BekiryY/fire_core_nano/doc/hero.png

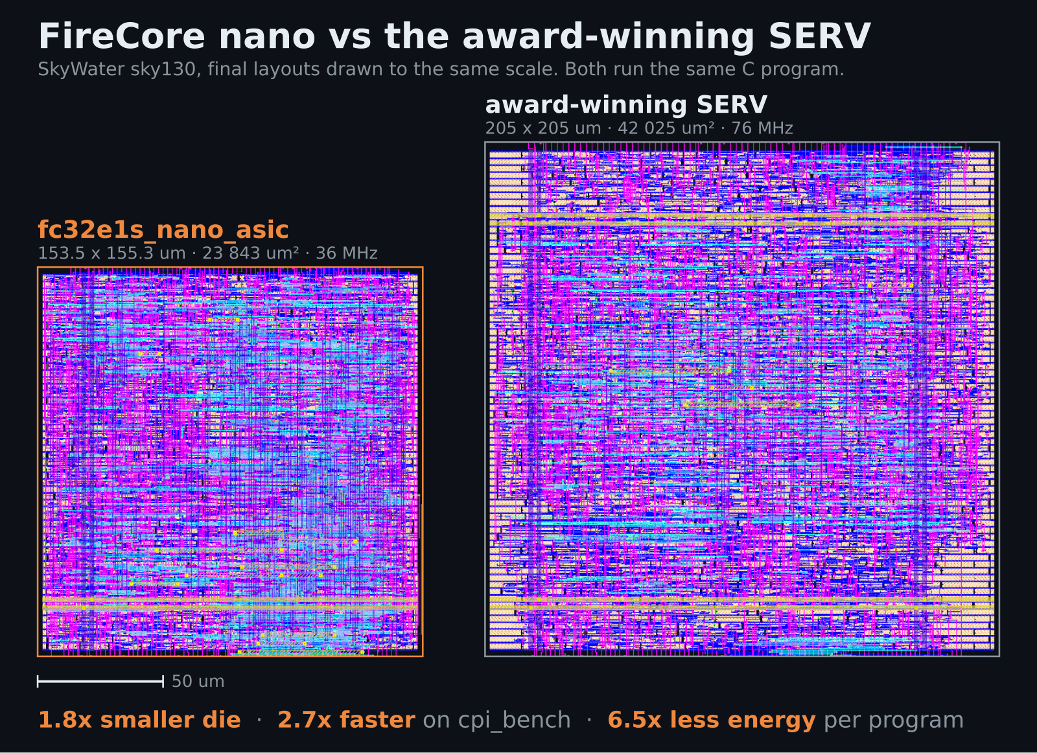
doc/hero.png
