BekiryY/fire_core_nano/results/README.md

# Results: FireCore nano vs SERV

The FireCore nano core compared with [SERV](https://github.com/olofk/serv) (bit-serial RISC-V,
Olof Kindgren), the usual reference for "smallest RISC-V core", once as an ASIC and once on an
FPGA, each against SERV built for the same target:

| Target | FireCore nano | SERV |
|---|---|---|
| ASIC, SkyWater sky130 | `fc32e1s_nano_asic` (byte-serial ALU, latch register file) | SERV RV32E, latch register file |
| FPGA, Xilinx 7-series (Vivado) | `fc32e1s_nano_fpga` (32-bit ALU, LUTRAM register file) | SERV, register file in block RAM |

Date: 2026-11-11 (SERV sky130 layout s8).

## Summary

| | ASIC (sky130) | FPGA (Vivado, core alone) |
|---|---|---|
| nano runs the benchmark | **2.7x faster** (2.4x at equal timing margin) | **6.7x faster** |
| at a clock of | 36 MHz vs SERV's 76 MHz | 81.7 MHz vs SERV's 150.4 MHz |
| size | **1.76x smaller die** | 1.29x more LUT-eq (529 vs 411: SERV 123 LUTs + 1 RAMB18) |
| other | **6.5x less energy** (gate-level activity) | **5.2x more speed per LUT-eq** |

SERV clocks 2.1x (ASIC) and 1.8x (FPGA) higher, but needs 5.6x and 12.4x more cycles for the
same C program. On sky130 the nano is both smaller and faster; on an FPGA SERV stays the smallest
core and the nano buys 6.7x the speed for 1.29x the area (LUT-eq).

## PPA score

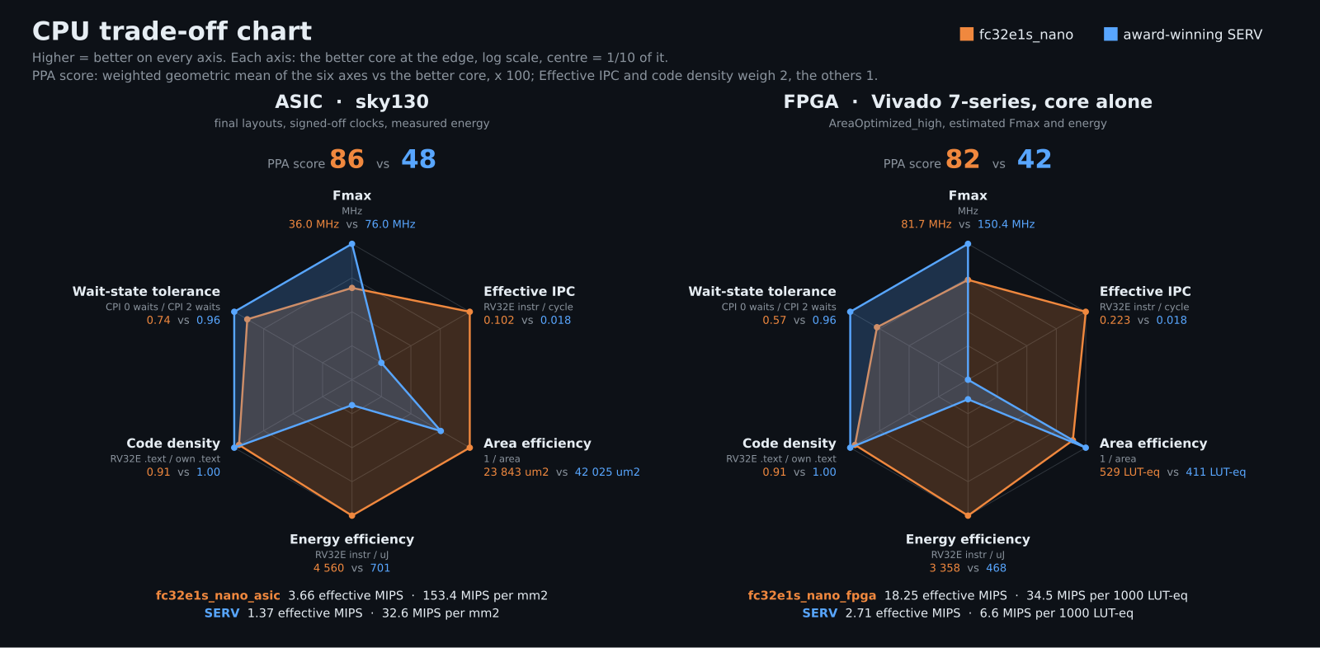
[picture p25: doc/tradeoff/tradeoff.png]
CPU trade-off chart


| PPA score | ASIC (sky130) | FPGA (Vivado, core alone) |
|---|---|---|
| fc32e1s_nano | **86** | **82** |
| SERV | 48 | 42 |

Six axes, each higher = better: Fmax, effective IPC, area efficiency, energy efficiency, code
density, wait-state tolerance (CPI with 0 waits / CPI with 2 waits). The PPA score is the
weighted geometric mean of each core's six values relative to the better core, x 100 (100 =
best on every axis). Effective IPC weighs 2: a CPU is a device that executes, and the work per
cycle is its main figure; Fmax only says whether the core runs at the system clock. Code
density weighs 2 as well: it is SERV's lead, and program memory often outweighs the core. The
other axes weigh 1. Chart and score:
[`doc/tradeoff/tradeoff_chart.py`](../doc/tradeoff/tradeoff_chart.py).

- **ASIC:** the final layouts and signed-off clocks of this page; energy is the measured CPI
  test energy per RV32E instruction (SERV's instruction count, 3 744).
- **FPGA:** area in LUT6 equivalents, a RAMB18 counted as 288 LUTs (18 Kb / 64 bits per LUTRAM
  LUT): nano 529, SERV 123 + 288 = 411. Energy is an estimate: Vivado's vectorless dynamic power
  at 100 MHz (default toggle rates), nano 6 652.5 uW, SERV 3 859.6 uW, per RV32E instruction.

## Software and method

`cpi_bench`: one C program (crc, fib, qsort, bsearch, list, interp, parse kernels), GCC 13.2.0
`-O2`, zero memory wait states. Each core runs its own compiler's code: the nano cores
`riscv32-nano-elf-gcc -mnano` ([`../toolchain`](../toolchain), 6 registers), SERV stock
`riscv64-unknown-elf-gcc -march=rv32e` (16 registers). Raw outputs: [`cpi_bench/`](cpi_bench/).

| Program | Code (.text) | Instructions |
|---|---|---|
| nano (`-mnano`, 6 registers) | 5 460 B | 1 465 222 |
| SERV (RV32E, 16 registers) | 4 972 B | 1 101 473 |

With 6 registers the program is 9.8 % larger and runs 33 % more instructions; every cycle count,
time and MIPS figure below includes that.

- **Complete time** = cycles / clock.
- **Effective MIPS** = the program's work in RV32E instructions (SERV's count, 1 101 473) /
  complete time, so the nano's extra instructions count against it. Native MIPS = the core's
  own instructions / time = clock / CPI.

The small CPI test in [`../bench/cpi_test`](../bench/cpi_test) (1 KiB image, same compilers) runs
on every core and board top of this comparison and agrees with `cpi_bench`.

## ASIC: fc32e1s_nano_asic vs SERV on sky130

SkyWater sky130A, `sky130_fd_sc_hd`, LibreLane Classic flow, signed off in all 9 corners
(ss / tt / ff x min / nom / max RC). Both cores are standard cells only (no SRAM macro); the
layouts are the core with its bus pins. Configs and metrics are in [`sky130/`](sky130/).

| | fc32e1s_nano_asic | SERV, RV32E |
|---|---|---|
| ISA, registers | RV32E, 6 (x0 ra sp a0..a2) | RV32E, 16 (x0..x15) |
| Datapath | byte-serial ALU | bit-serial |
| Register file | latches, one clock gate per byte lane | latches (`dlxtp_1`), one clock gate per word |
| Die | 153.5 x 155.3 um = **23 843 um2** | 205 x 205 um = **42 025 um2** |
| Standard cells | **18 505 um2** | **30 657 um2** |
| of which sequential | 5 095 um2 | 13 992 um2 |
| Cell density (fill excluded) | 82.7 % | 76.8 % |
| Clock (signed off) | **36 MHz** (ss Fmax 37.0 MHz, max RC) | **76 MHz** (ss setup slack +1.67 ns) |
| Hold, worst | +0.106 ns | +0.093 ns |
| DRC (Magic, KLayout) / LVS / antenna | clean | clean |
| Max slew (1.1 ns limit) | 1 net at 1.13 ns (ss) | clean |
| Wire length | 67.7 mm | 74.6 mm |
| Power, CPI test activity (tt) | **0.777 mW** at 36 MHz | **2.062 mW** at 76 MHz |
| Power, vectorless (OpenSTA / LibreLane) | 1.95 / 2.33 mW | 4.40 / 5.22 mW |

| fc32e1s_nano_asic | SERV, RV32E |
|---|---|
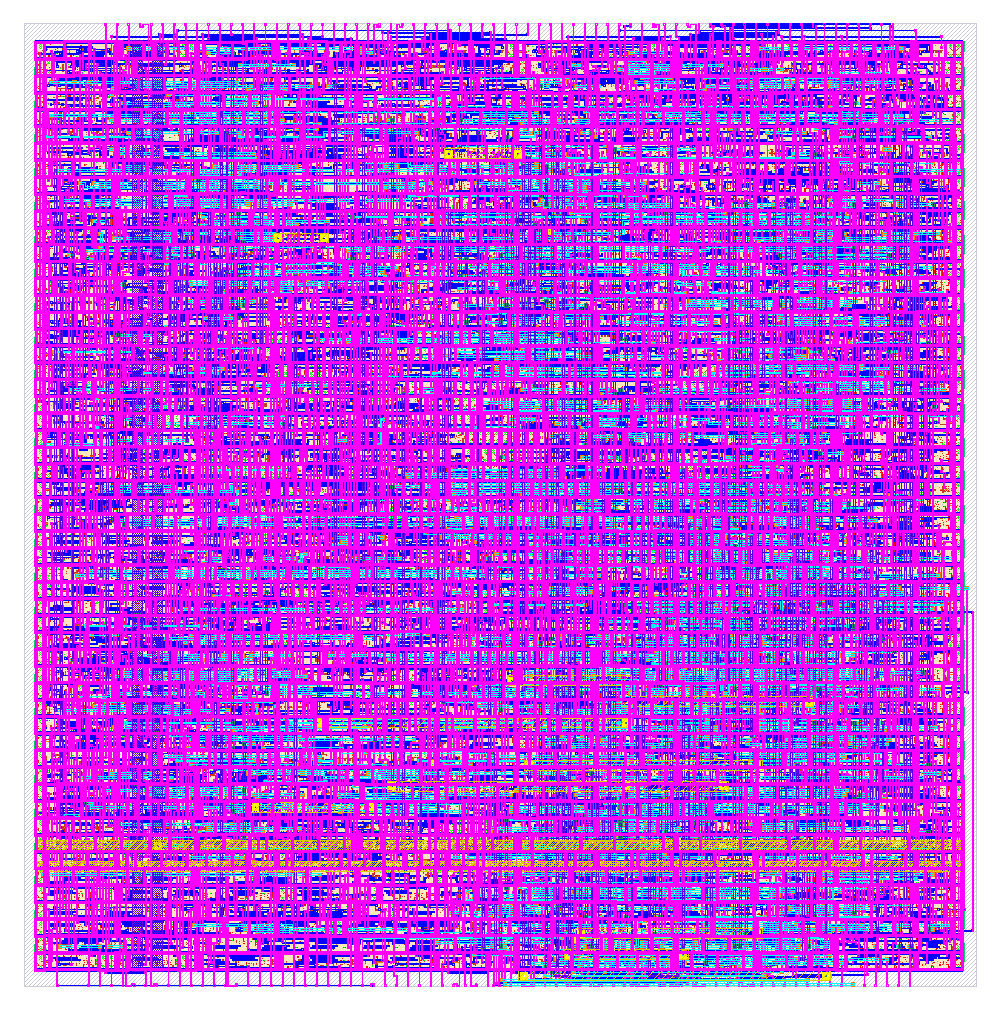
[picture p26: results/sky130/fc32e1s_nano_asic/fc32e1s_nano_asic_hard.png]
fc32e1s_nano_asic layout
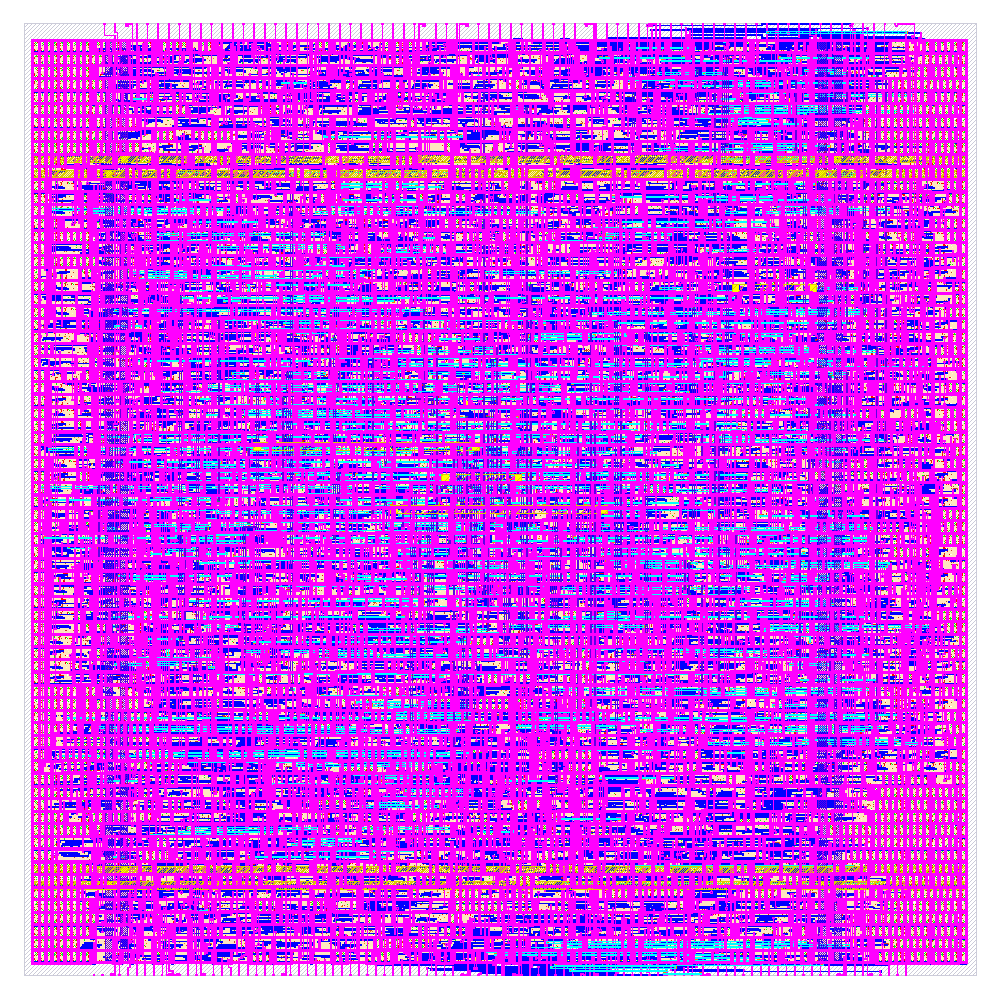
[picture p27: results/sky130/serv_rv32e/serv_rf_top_latch.png]
SERV layout
|  |  |
| 153.5 x 155.3 um | 205 x 205 um, pins on N + S (images are not to the same scale) |

Performance, `cpi_bench`, at each core's signed-off clock:

| | fc32e1s_nano_asic | SERV, RV32E | nano advantage |
|---|---|---|---|
| Cycles | 10 839 619 | 61 037 635 | 5.6x fewer |
| CPI | 7.40 | 55.42 | |
| Complete time | 10.84 M / 36 MHz = **301 ms** | 61.04 M / 76 MHz = **803 ms** | 2.67x faster |
| Effective MIPS | **3.66** | **1.37** | 2.67x |
| Native MIPS | 4.87 | 1.37 | |
| Code (.text) | 5 460 B | 4 972 B | 1.10x larger |
| Die area | 23 843 um2 | 42 025 um2 | 1.76x smaller |
| Speed per die area | | | 4.7x |
| Energy, from the CPI test's energy per cycle | 21.6 pJ x 10.84 M = **234 uJ** | 27.2 pJ x 61.04 M = **1661 uJ** | 7.1x less |

CPI test: nano 36 392 cycles, 1.01 ms (3.49 effective MIPS); SERV 183 729 cycles, 2.42 ms
(1.46); 2.4x.

**Energy, measured.** `cpi_bench` (5.5 KiB) does not fit the nano layout's 2 KiB instruction
space, so the energy is measured with the CPI test, which runs on both final netlists:
gate-level simulation at the signed-off clock, every cell pin's toggles recorded (SAIF), OpenSTA
with the layout's parasitics at tt 025C 1v80 ([`../bench/power`](../bench/power), reports in
[`power/`](power/)). CPU only: the memory is outside the netlists.

| CPI test, reset to end | fc32e1s_nano_asic | SERV, RV32E | |
|---|---|---|---|
| Cycles / instructions | 38 066 / 5 482 | 196 149 / 3 744 | |
| Time | 1057 us at 36 MHz | 2589 us at 76 MHz | |
| Power | **0.777 mW** (sequential 0.208, combinational 0.370, clock 0.199) | **2.062 mW** (sequential 1.111, combinational 0.195, clock 0.756) | |
| Energy | **0.821 uJ** | **5.338 uJ** | **6.5x less** |
| per cycle | 21.6 pJ | 27.2 pJ | 1.26x less |
| per instruction | 150 pJ | 1426 pJ | |

The real activity is 2.5x (nano) and 2.1x (SERV) lower than the vectorless estimates. SERV
spends more energy per cycle (most of it in its sequential cells and its clock tree)
and needs 5.2x the cycles. The energy per program does not depend on the clock (power scales
with it), so the equal-margin comparison changes only the time, not the energy.

- **Clock margins differ.** At the slow corner (ss 100C 1.60 V, max RC) SERV runs 76 MHz against
  an Fmax of about 86.7 MHz (12.7 % margin), the nano 36 MHz against 37.0 MHz (2.7 %; 39.5 MHz at
  min RC). Compared at their Fmax (293 vs 704 ms), or both at 12.7 % margin (nano 32.3 MHz, 336
  vs 803 ms), the nano finishes `cpi_bench` **2.4x** sooner instead of 2.7x.
- **Densities differ.** SERV was laid out at 76.8 % cell density, the nano at 82.7 %. At the
  nano's density SERV's die would be about 39 000 um2, still 1.6x the nano's.
- **Power** is simulation-annotated at the typical corner with zero-delay activity (no glitches,
  so combinational switching is a lower bound), not a silicon measurement. `cpi_bench`'s energy
  is the CPI test's energy per cycle times `cpi_bench`'s cycles.
- **SERV configuration.** Upstream SERV with `WITH_CSR = 0` (no CSRs, traps or timer interrupt;
  the nano has none either), `W = 1`, RV32E (registers x0..x15), and its register-file RAM
  replaced by a latch register file (`common/rtl/regfile/rf32x32_2r1w_latch.sv`). The latch
  register file does not change SERV's timing in cycles: an RV32I build runs `cpi_bench` in
  exactly the stock SERV cycle count.

## FPGA: fc32e1s_nano_fpga vs SERV, Vivado, core alone

Each CPU alone, without memory or peripherals: Vivado 2025.2 out-of-context synthesis,
xc7z020clg400-1 (Artix-7 fabric: LUT6, CARRY4, LUTRAM, RAMB18; no Artix-7 part is installed
here; -1 speed grade), 10 ns clock constraint, directive `AreaOptimized_high` (this is a comparison of small cores),
Fmax estimated from the
synthesis WNS (register to register; the bus ports are not pins). Scripts:
[`fc32e1s_nano_fpga_core.tcl`](../cores/fc32e1s_nano_fpga/appl/vivado/fc32e1s_nano_fpga_core.tcl),
[`serv_core.tcl`](../cores/serv/appl/vivado/serv_core.tcl).

| | fc32e1s_nano_fpga | SERV |
|---|---|---|
| Top | `fc32e1s_nano_fpga_core` | `serv_rf_top`, `WITH_CSR = 0` (core + register file RAM) |
| LUTs | **529** (481 logic + 48 LUTRAM: the register file) | **123** (logic) |
| Flip-flops | 59 | 164 |
| Block RAM | 0 | 1 RAMB18 (the register file) |
| CARRY4 / MUXF7 | 21 / 6 | 0 / 0 |
| Fmax, estimated | **81.7 MHz** | **150.4 MHz** |
| directive Default | 572 LUTs, 77.5 MHz | 133 LUTs, 164.7 MHz |

Performance, `cpi_bench`, at each core's estimated Fmax (`AreaOptimized_high`):

| | fc32e1s_nano_fpga | SERV | nano advantage |
|---|---|---|---|
| Cycles | 4 931 283 | 61 037 635 | 12.4x fewer |
| CPI | 3.37 | 55.42 | |
| Complete time | 4.93 M / 81.7 MHz = **60.4 ms** | 61.04 M / 150.4 MHz = **405.8 ms** | 6.72x faster |
| Effective MIPS | **18.25** | **2.71** | 6.72x |
| Native MIPS | 24.28 | 2.71 | |
| Code (.text) | 5 460 B | 4 972 B | 1.10x larger |
| Area, LUT-eq | 529 | 411 (123 LUTs + 1 RAMB18 = 288) | 1.29x more |
| Effective MIPS per 1000 LUT-eq | 34.5 | 6.6 | 5.2x |

- **Area in LUT-eq.** LUT6 equivalents: LUTs + 288 per RAMB18 (18 Kb / 64 bits per LUTRAM
  LUT), so SERV's register file counts as the block RAM it occupies. It uses only 1 Kb of it:
  as LUTRAM its 1024 bits would be about 16 LUTs (139 LUTs: 1.77x per LUT instead of 5.2x).
- **Synthesis estimate.** Fmax from synthesis uses estimated wire delays; place and route
  changes it, not equally for both cores. The nano's board top, with RAM and peripheral, reaches
  94.6 MHz after place and route (directive Default) against 77.5 MHz estimated for the core
  alone with the same directive.
- **SERV configuration.** Upstream `serv_rf_top` (`PRE_REGISTER = 1`, `RESET_STRATEGY = "MINI"`,
  as in the board top) with `RESET_PC = 0`, `WITH_CSR = 0`, running the RV32E program. Its cycle
  counts match the sky130 SERV exactly (CPI test: 183 729 cycles on both).
- **Power, estimated.** Both scripts end with `report_power` (vectorless, default toggle rates,
  at the 10 ns constraint): dynamic power nano 6 652.5 uW, SERV 3 859.6 uW. Used only for the
  FPGA energy axis of the [PPA score](#ppa-score).

### Board tops on Gowin GW2A-18

Each core in the same board top (core + 2 KiB block RAM + LED / counter peripheral + reset
synchronizer), synthesis and place and route on GW2A-LV18PG256C8/I7, Gowin EDA 1.9.12.04, same
strategy for both ([`gw_project.tcl`](../cores/fc32e1s_nano_fpga/appl/gw2a/gw_project.tcl): area
goal, max fanout 12, 100 MHz constraint, Fmax from the timing report, no pin constraints). The
CPI test runs on these tops in xsim.

| | fc32e1s_nano_fpga top | SERV top |
|---|---|---|
| Board top | [`fc32e1s_nano_fpga_top.sv`](../cores/fc32e1s_nano_fpga/example/subsystem/fc32e1s_nano_fpga_top.sv) | [`serv_fpga_top.sv`](../cores/serv/example/subsystem/serv_fpga_top.sv) |
| Logic | 1225 (963 LUT, 166 ALU, 16 RAM16) | 388 (307 LUT, 69 ALU, 2 RAM16) |
| Registers | 171 | 281 |
| Block RAM | 4 (the 2 KiB RAM) | 5 (the 2 KiB RAM + the register file) |
| Fmax | 61.6 MHz | 139.8 MHz |
| `cpi_bench` time | 80.0 ms (13.77 effective MIPS) | 436.5 ms (2.52) |
| CPI test time | 297 us | 1314 us |

The nano has AXI4-Lite instruction and data ports, SERV Wishbone; each board top connects them
to the RAM directly, one wait state per access for both.
