BekiryY/fire_core_nano/cores/fc32e1s_nano_asic/rtl/fc32e1s_nano_asic_immgen.sv

// fc32e1s_nano_asic_immgen.sv
// Immediate extraction and sign extension for I/S/B/U/J formats.

module fc32e1s_nano_asic_immgen
  import fc32e1s_nano_asic_pkg::*;
(
  input  logic [31:0] instr_i,
  input  imm_sel_e    imm_sel_i,
  output logic [31:0] imm_o
);

  always_comb begin
    unique case (imm_sel_i)
      IMM_I:   imm_o = {{20{instr_i[31]}}, instr_i[31:20]};
      IMM_S:   imm_o = {{20{instr_i[31]}}, instr_i[31:25], instr_i[11:7]};
      IMM_B:   imm_o = {{19{instr_i[31]}}, instr_i[31], instr_i[7], instr_i[30:25], instr_i[11:8], 1'b0};
      IMM_U:   imm_o = {instr_i[31:12], 12'b0};
      IMM_J:   imm_o = {{11{instr_i[31]}}, instr_i[31], instr_i[19:12], instr_i[20], instr_i[30:21], 1'b0};
      default: imm_o = '0;
    endcase
  end

endmodule
