BekiryY/fire_core_nano/(commit log)

2026-11-08 necessary source files added
    [pin_order.cfg]
2026-11-08 fc32e1s_nano_fpga: CPU subsystem with GW2A project and C CPI test
    example/subsystem: core + 2 KiB block RAM (code, data, stack; program = RAM init) + one
    AXI4-Lite peripheral port at 0x800; board top with LED / CYCLE / INSTRET / SIM registers.
    sw/: cpi_test.c (6 kernels, self-checking), crt0, linker script, build.sh (stock GCC with
    -ffixed-* or riscv32-nano-elf-gcc -mnano; rejects other registers). run_sim.sh (xsim): PASS,
    CPI 3.51. appl/gw2a/subsystem: GW2A-18 1225 logic, 171 REG, 4 BSRAM, 61.6 MHz.
2026-11-08 toolchain + sw: riscv32-nano-elf (-mnano GCC, picolibc) and the nano-core BSP
    toolchain/: build.sh builds binutils 2.42, GCC 13.2.0 + patches/gcc-13.2.0-mnano.patch
    (C for the 6 registers x0 ra sp a0..a2: 3 argument registers, varargs on the stack,
    indirect calls through ra, no callee-saved registers) and picolibc 1.8.10 +
    patches/picolibc-1.8.10-mnano.patch (nano asm memcpy/memmove/memset/strcmp/setjmp).
    -mnano disables -fcse-follow-jumps (LRA never converged on picolibc libm/stdio) and
    the patch stops a non-converging allocation with an error instead of spinning.
    package.sh makes the release tarball; test/run_tests.sh: abi.c + libc.c at O0/O2/Os,
    register check + Spike: all pass on a clean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
    [bsp.c]
2026-11-09 bench/power, results: measured CPU power from CPI-test activity; SERV FPGA board top
    - bench/power: gate-level xsim of both sky130 final netlists running the CPI test at the
    signed-off clock, SAIF from reset release to the program's end, OpenSTA (tt, nom SPEF)
    with read_saif; fix_saif.py maps xsim names for OpenSTA. All pins annotated.
    nano 0.777 mW / 0.821 uJ, SERV 2.279 mW / 5.259 uJ: 6.4x less energy (vectorless 1.95 / 4.82 mW).
    - cores/serv: serv_fpga_top (same RAM and peripheral as the nano board top) + Gowin project;
    cpi_test serv_fpga target. 388 logic, 139.8 MHz.
    - results/README: ASIC and FPGA comparisons with measured energy.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
    [serv_fpga_top.sv, tb_cpi_serv_fpga.sv, tb_gl_nano.sv, tb_gl_serv.sv]
2026-11-09 power_method.md: how the real activity and CPU power are measured
2026-11-09 cores: public READMEs; drop the stale SERV Gowin project and Turkish leftovers
    - cores/serv/gw2a/serv.gprj removed (absolute paths to the original clone; replaced by
    appl/gw2a); PROVENANCE.md and .gitignore follow.
    - fc32e1s_nano_asic / _fpga README: what the core is, its numbers, how to run it; no
    development history (that stays in rtl/HISTORY), no links outside the repo.
    - verif/env/spike_iss/README.md: short English README of the Spike vs RTL flow, replacing the
    Turkish one from another project; stale generated KAPSAM.md removed.
    - fc32e1s_nano_asic/example/subsystem/README.md: only what the folder contains.
2026-11-09 fc32e1s_nano_fpga: Vivado project script (core alone or board top)
    appl/vivado/vivado_project.tcl creates an .xpr of the core alone (out of context) or the
    board top (core + 2 KiB block RAM + peripheral, RAM loaded with the CPI test image), and with
    RUN=syn / RUN=1 builds it; PART, PERIOD, PRJ_DIR options. Board top on xc7z020clg400-1 after
    place and route: 648 LUT (44 LUTRAM), 177 FF, 2 BRAM tiles, 94.6 MHz.
2026-11-09 results: FPGA comparison on Vivado synthesis of the cores alone, AreaOptimized_high
    - cores/serv/appl/vivado/serv_core.tcl: out-of-context synthesis of serv_rf_top
    (WITH_CSR = 0), the same set-up as the nano's (xc7z020, 10 ns).
    - Both Vivado core scripts default to AreaOptimized_high (a comparison of small cores):
    nano 529 LUT (48 LUTRAM), 59 FF, est. 81.7 MHz; SERV 123 LUT, 164 FF, 1 RAMB18, est. 150.4 MHz.
    - results/README: cpi_bench 60.4 vs 405.8 ms (6.7x), 1.56x effective MIPS per LUT; the Gowin
    board tops kept as a subsection.
2026-11-11 bench/power: SERV measured on the final s8 layout (205 x 205 um, 76 MHz)
    SERV period 13.2 ns (76 MHz). CPI test activity: 2.062 mW, 5.338 uJ, 27.2 pJ/cycle
    (s6: 2.279 mW, 5.259 uJ); vectorless 4.395 mW. Nano 0.821 uJ: 6.5x less energy.
    results/power/serv_* replaced; power_method.md updated.
    [tb_gl_serv.sv]
2026-11-11 results, SERV flow: sync to the final SERV layout s8 (205 x 205 um, 76 MHz)
    SERV sky130: config (76 MHz, 205 um die, nano margins) + pin_order.cfg (pins N + S), metrics
    and render of run s8 (30 657 um2 cells, 76.8 %, clean, ss setup +1.67 ns, hold +93 ps).
    results/README.md: die 42 025 um2 (nano 1.76x smaller), cpi_bench 803 ms (nano 2.67x faster,
    2.4x at equal margin), energy 5.338 uJ (6.5x), 4.7x speed per area; margin and density notes.
    bench/cpi_test/README.md: SERV rows at 76 MHz (nano 2.4x sooner).
    fc32e1s_nano_asic README: block diagram, single-stage multi-cycle note.
    [pin_order.cfg]
2026-11-13 results: PPA score and CPU trade-off chart (ASIC 86 vs 48, FPGA 82 vs 42)
    Six-axis chart (Fmax, effective IPC, area, energy, code density, wait-state
    tolerance) for the nano vs SERV on sky130 and Vivado. PPA score: weighted
    geometric mean vs the better core, x 100; IPC and code density weigh 2.
    Vivado core scripts now report vectorless power (FPGA energy estimate).
